fernandomcrsilva/Sistemas-Digitais/Ap1 parte2/docs/AP1_desenho_protoboard_2bits.pdf

AP1 · | Conferência de carga: montagem nas protoboards
Arduino Mega 2560 + 2 protoboards de 830 pontos · | versão de 2 bits por potenciômetro (X1 X0 em D23 D22, B1 B0 em D33 D32) · | 4 CIs · | conferida ligação por ligação (34 redes, 66 fios) · | CIs da esquerda

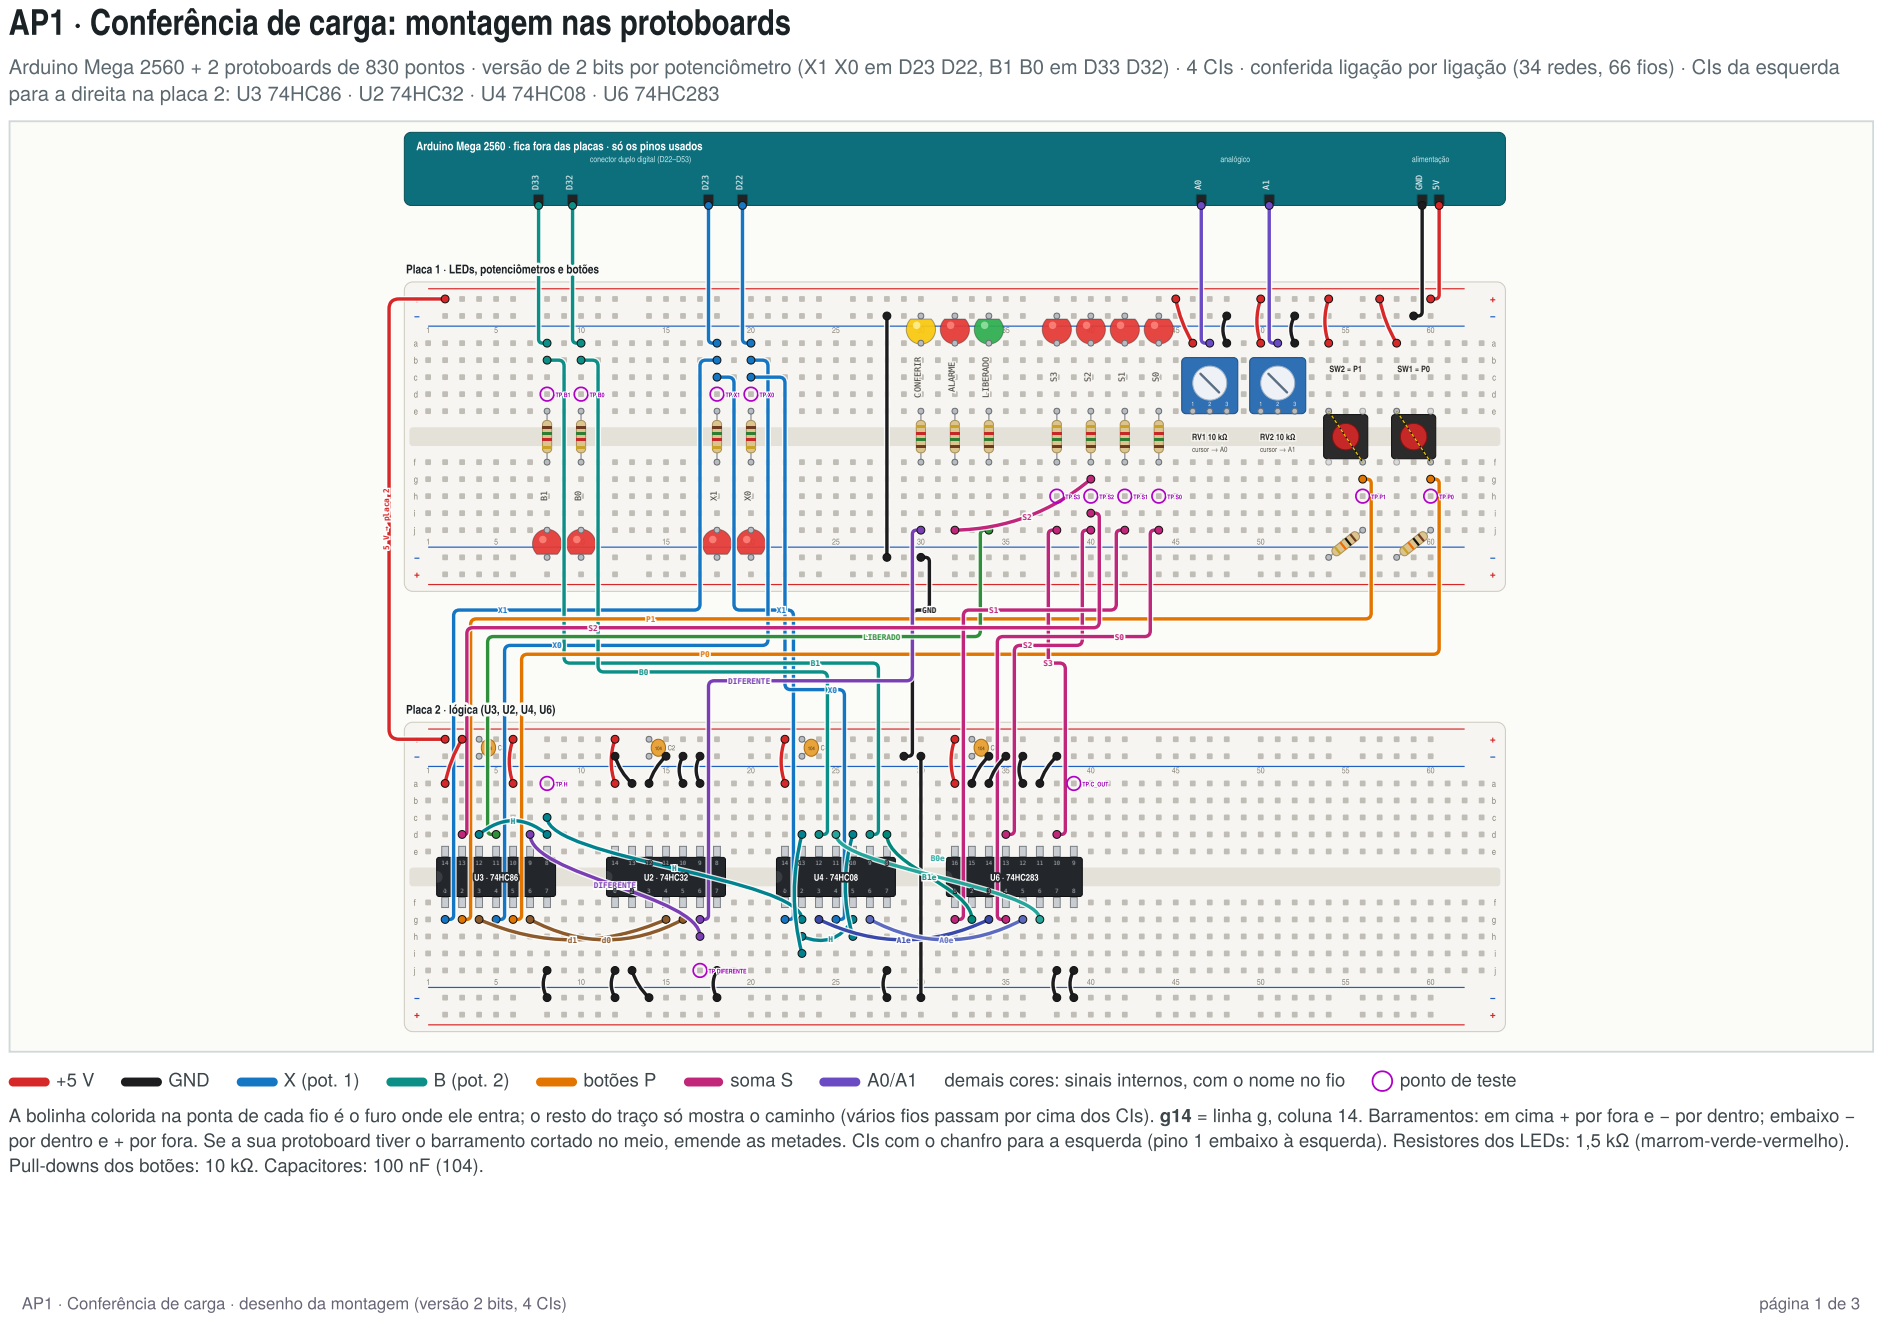
[picture p7: page 1]

Placa 1 · LEDs, potenciômetros e botões

A bolinha colorida na ponta de cada fio é o furo onde ele entra; o resto do traço só mostra o caminho (vários fios passam por cima dos CIs). g14 = linha g, coluna 14. Barramentos: em cima + por fora e − por dentro; embaixo −

por dentro e + por fora. Se a sua protoboard tiver o barramento cortado no meio, emende as metades. CIs com o chanfro para a esquerda (pino 1 embaixo à esquerda). Resistores dos LEDs: 1,5 kΩ (marrom-verde-vermelho).

Pull-downs dos botões: 10 kΩ. Capacitores: 100 nF (104).

Placa 1 · | LEDs, potenciômetros e botões (ampliada)
Arduino Mega 2560 · | fica fora das placas · | só os pinos usados

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
conector duplo digital (D22–D53) | analógico | alimentação
+ | +
− | −
− | −
+ | +
a | a
b | b
c | c
d | d
e | e
f | f
g | g
h | h
i | i
j | j

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
# CONFERIR CONFERIR

# ALARME ALARME

# LIBERADO LIBERADO

S3
S2

S1

S0

1 | 2 | 3

RV1 10 kΩ

## ccuurrssoorr →→ AA00

1 | 2 | 3

RV2 10 kΩ

## ccuurrssoorr →→ AA11

SW2 = P1 | SW1 = P0

5 V

→

## placa

## 2 5 V → placa 2

S22

TP B11 | TP B0 | TP XX11 | TP XX0
TP S3 | TP S2 | TP S11 | TP S0 | TP P11 | TP P0

# Placa 1 · LEDs, potenciômetros e botões

+5 V | GND | X (pot. 1) | B (pot. 2) | botões P | soma S | A0/A1 | demais cores: sinais internos, com o nome no fio | ponto de teste

A bolinha colorida na ponta de cada fio é o furo onde ele entra; o resto do traço só mostra o caminho (vários fios passam por cima dos CIs). g14 = linha g, coluna 14. Barramentos: em cima + por fora e − por dentro; embaixo −

por dentro e + por fora. Se a sua protoboard tiver o barramento cortado no meio, emende as metades. CIs com o chanfro para a esquerda (pino 1 embaixo à esquerda). Resistores dos LEDs: 1,5 kΩ (marrom-verde-vermelho).

Pull-downs dos botões: 10 kΩ. Capacitores: 100 nF (104).

AP1 · | Conferência de carga · | desenho da montagem (versão 2 bits, 4 CIs) | página 2 de 3

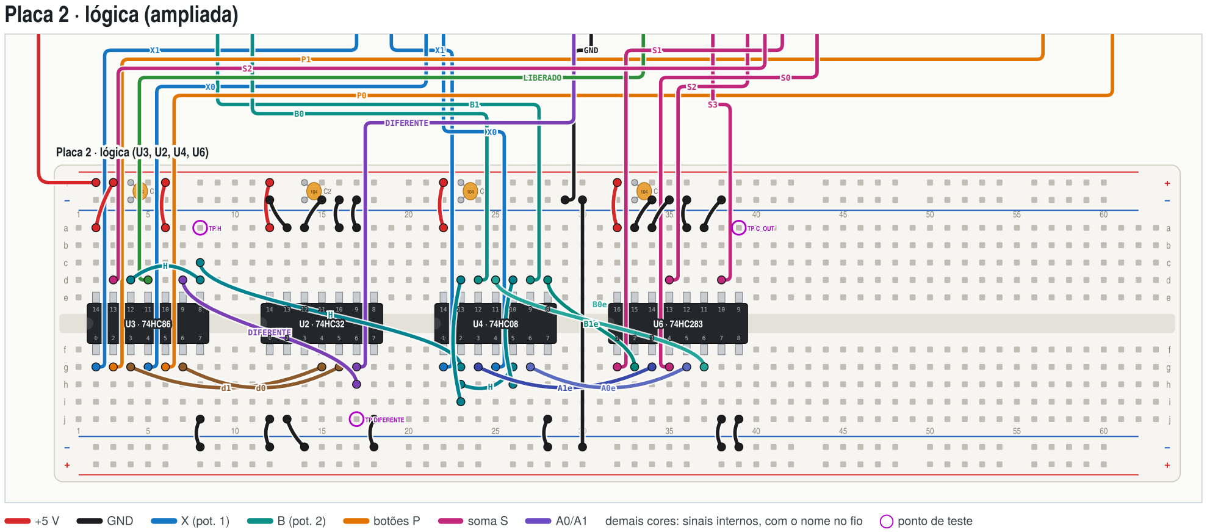
[picture p8: figure]
Placa 2 ·; lógica (ampliada); GND; DDIIFFEERREENNTTEE; LLIIBBEERRAADDOO; TTPP DDIIFFEERREENNTTEE; TTPP CC__OOUUTT; UU33 ·· 7744HHCC8866; UU22 ·· 7744HHCC3322; UU44 ·· 7744HHCC0088; UU66 ·· 7744HHCC228833

# Placa 2 · lógica (U3, U2, U4, U6)

+5 V | GND | X (pot. 1) | B (pot. 2) | botões P | soma S | A0/A1 | demais cores: sinais internos, com o nome no fio | ponto de teste

A bolinha colorida na ponta de cada fio é o furo onde ele entra; o resto do traço só mostra o caminho (vários fios passam por cima dos CIs). g14 = linha g, coluna 14. Barramentos: em cima + por fora e − por dentro; embaixo −

por dentro e + por fora. Se a sua protoboard tiver o barramento cortado no meio, emende as metades. CIs com o chanfro para a esquerda (pino 1 embaixo à esquerda). Resistores dos LEDs: 1,5 kΩ (marrom-verde-vermelho).

Pull-downs dos botões: 10 kΩ. Capacitores: 100 nF (104).

AP1 · | Conferência de carga · | desenho da montagem (versão 2 bits, 4 CIs) | página 3 de 3
