fernandomcrsilva/Sistemas-Digitais/Ap1 parte2/paginas/montagem-protoboard.html

AP1 · Sistemas Digitais 2026.2 · turma 6a

# Montagem da conferência de carga

Arduino Mega 2560 e duas protoboards de 830 pontos, na versão de 2 bits por potenciômetro: cada potenciômetro vira um valor de 0 a 3, o Mega acende X1 X0 (D23 D22) e B1 B0 (D33 D32), e a lógica usa 4 CIs (74HC86, 74HC32, 74HC08 e 74HC283). Cada ligação foi conferida por script contra o esquema.

34 de 34 redes iguais ao esquema · 66 fios

1 Alimentação2 Potenciômetros e botões3 Arduino → placa 14 Entre as placas5 Lógica na placa 2

Destacar − Ajustar +

+5 V GND X B botões P soma S A0/A1 demais cores: sinais internos, com o nome no fio ponto de teste clique num fio para destacar a rede

Destacando Limpar

Passo 1

### Alimentação

0/14

Mega nos barramentos, + e − entre as placas, VCC e GND de cada CI.

| # | Rede | De | | Para
| 1 | GND | Mega GND | → | 1·−59barramento − de cima
| 2 | VCC | Mega 5V | → | 1·+60barramento + de cima
| 3 | VCC | 1·+2barramento + de cima | → | 2·+2barramento + de cima
| 4 | GND | 1·−28barramento − de cima | → | 1·−28barramento − de baixo
| 5 | GND | 2·−30barramento − de cima | → | 2·−30barramento − de baixo
| 6 | GND | 1·−30barramento − de baixo | → | 2·−29barramento − de cima
| 7 | GND | 2·j8U3 pino 7 | → | 2·−8barramento − de baixo
| 8 | GND | 2·j18U2 pino 7 | → | 2·−18barramento − de baixo
| 9 | GND | 2·j28U4 pino 7 | → | 2·−28barramento − de baixo
| 10 | GND | 2·j39U6 pino 8 | → | 2·−39barramento − de baixo
| 11 | VCC | 2·a2U3 pino 14 | → | 2·+3barramento + de cima
| 12 | VCC | 2·a12U2 pino 14 | → | 2·+12barramento + de cima
| 13 | VCC | 2·a22U4 pino 14 | → | 2·+22barramento + de cima
| 14 | VCC | 2·a32U6 pino 16 | → | 2·+32barramento + de cima

Passo 2

### Potenciômetros e botões

0/6

Ligações curtas da placa 1 ao + e ao −.

| # | Rede | De | | Para
| 15 | GND | 1·a48RV1 pino 3 | → | 1·−48barramento − de cima
| 16 | GND | 1·a52RV2 pino 3 | → | 1·−52barramento − de cima
| 17 | VCC | 1·a46RV1 pino 1 | → | 1·+45barramento + de cima
| 18 | VCC | 1·a50RV2 pino 1 | → | 1·+50barramento + de cima
| 19 | VCC | 1·a54SW2 pino 1 | → | 1·+54barramento + de cima
| 20 | VCC | 1·a58SW1 pino 1 | → | 1·+57barramento + de cima

Passo 3

### Arduino → placa 1

0/6

Um fio por pino do Mega: D22–D25, D32–D35, A0, A1.

| # | Rede | De | | Para
| 21 | A0 | Mega A0 | → | 1·a47RV1 pino 2
| 22 | A1 | Mega A1 | → | 1·a51RV2 pino 2
| 23 | B0 | Mega D32 | → | 1·a10R11 · coluna do LED B0
| 24 | B1 | Mega D33 | → | 1·a8R12 · coluna do LED B1
| 25 | X0 | Mega D22 | → | 1·a20R1 · coluna do LED X0
| 26 | X1 | Mega D23 | → | 1·a18R2 · coluna do LED X1

Passo 4

### Entre as placas

0/16

Entradas da lógica e saídas para os LEDs.

| # | Rede | De | | Para
| 27 | B0 | 1·b10R11 · coluna do LED B0 | → | 2·d24U4 pino 12
| 28 | B1 | 1·b8R12 · coluna do LED B1 | → | 2·d27U4 pino 9
| 29 | DIFERENTE | 2·g17U2 pino 6 | → | 1·j30R17 · coluna do LED CONFERIR
| 30 | LIBERADO | 2·d5U3 pino 11 | → | 1·j34R19 · coluna do LED LIBERADO
| 31 | P0 | 1·g60SW1 pino 3 | → | 2·g6U3 pino 5
| 32 | P1 | 1·g56SW2 pino 3 | → | 2·g3U3 pino 2
| 33 | S0 | 2·g35U6 pino 4 | → | 1·j44R13 · coluna do LED S0
| 34 | S1 | 2·g32U6 pino 1 | → | 1·j42R14 · coluna do LED S1
| 35 | S2 | 2·d35U6 pino 13 | → | 1·j40R15 · coluna do LED S2
| 36 | S2 | 1·i40R15 · coluna do LED S2 | → | 2·d3U3 pino 13
| 37 | S3 | 2·d38U6 pino 10 | → | 1·j38R16 · coluna do LED S3
| 38 | X0 | 1·b20R1 · coluna do LED X0 | → | 2·g5U3 pino 4
| 39 | X0 | 1·c20R1 · coluna do LED X0 | → | 2·g25U4 pino 4
| 40 | X1 | 1·b18R2 · coluna do LED X1 | → | 2·g2U3 pino 1
| 41 | X1 | 1·c18R2 · coluna do LED X1 | → | 2·g22U4 pino 1
| 42 | S2 | 1·g40R15 · coluna do LED S2 | → | 1·j32R18 · coluna do LED ALARME

Passo 5

### Lógica na placa 2

0/24

Ligações entre portas e entradas ociosas no GND.

| # | Rede | De | | Para
| 43 | A0e | 2·g27U4 pino 6 | → | 2·g36U6 pino 5
| 44 | A1e | 2·g24U4 pino 3 | → | 2·g34U6 pino 3
| 45 | B0e | 2·d25U4 pino 11 | → | 2·g37U6 pino 6
| 46 | B1e | 2·d28U4 pino 8 | → | 2·g33U6 pino 2
| 47 | DIFERENTE | 2·h17U2 pino 6 | → | 2·d7U3 pino 9
| 48 | H | 2·d8U3 pino 8 | → | 2·d4U3 pino 12
| 49 | H | 2·c8U3 pino 8 | → | 2·g23U4 pino 2
| 50 | H | 2·h23U4 pino 2 | → | 2·g26U4 pino 5
| 51 | H | 2·i23U4 pino 2 | → | 2·d23U4 pino 13
| 52 | H | 2·h26U4 pino 5 | → | 2·d26U4 pino 10
| 53 | d0 | 2·g7U3 pino 6 | → | 2·g16U2 pino 5
| 54 | d1 | 2·g4U3 pino 3 | → | 2·g15U2 pino 4
| 55 | GND entrada ociosa | 2·a13U2 pino 13 | → | 2·−12barramento − de cima
| 56 | GND entrada ociosa | 2·a14U2 pino 12 | → | 2·−15barramento − de cima
| 57 | GND entrada ociosa | 2·a16U2 pino 10 | → | 2·−16barramento − de cima
| 58 | GND entrada ociosa | 2·a17U2 pino 9 | → | 2·−17barramento − de cima
| 59 | GND entrada ociosa | 2·a33U6 pino 15 | → | 2·−34barramento − de cima
| 60 | GND entrada ociosa | 2·a34U6 pino 14 | → | 2·−35barramento − de cima
| 61 | GND entrada ociosa | 2·a36U6 pino 12 | → | 2·−36barramento − de cima
| 62 | GND entrada ociosa | 2·a37U6 pino 11 | → | 2·−38barramento − de cima
| 63 | GND entrada ociosa | 2·j12U2 pino 1 | → | 2·−12barramento − de baixo
| 64 | GND entrada ociosa | 2·j13U2 pino 2 | → | 2·−14barramento − de baixo
| 65 | GND entrada ociosa | 2·j38U6 pino 7 | → | 2·−38barramento − de baixo
| 66 | VCC entrada ociosa | 2·a6U3 pino 10 | → | 2·+6barramento + de cima

Onde vai cada componente

Ref. | Peça | Posição
U3 | 74HC86 | Placa 2, colunas 2–8, atravessando o canal. Pino 1 em f2, chanfro para a esquerda.
U2 | 74HC32 | Placa 2, colunas 12–18, atravessando o canal. Pino 1 em f12, chanfro para a esquerda.
U4 | 74HC08 | Placa 2, colunas 22–28, atravessando o canal. Pino 1 em f22, chanfro para a esquerda.
U6 | 74HC283 | Placa 2, colunas 32–39, atravessando o canal. Pino 1 em f32, chanfro para a esquerda.
C3 | 100 nF (104) | Placa 2, entre os barramentos + e − de cima, coluna 4.
C2 | 100 nF (104) | Placa 2, entre os barramentos + e − de cima, coluna 14.
C4 | 100 nF (104) | Placa 2, entre os barramentos + e − de cima, coluna 23.
C6 | 100 nF (104) | Placa 2, entre os barramentos + e − de cima, coluna 33.
R12 + D12 | 1,5 kΩ + LED vermelho (B1) | Placa 1: R12 de e8 a f8; LED com a perna longa em j8 e o lado chato no − de baixo.
R11 + D11 | 1,5 kΩ + LED vermelho (B0) | Placa 1: R11 de e10 a f10; LED com a perna longa em j10 e o lado chato no − de baixo.
R2 + D2 | 1,5 kΩ + LED vermelho (X1) | Placa 1: R2 de e18 a f18; LED com a perna longa em j18 e o lado chato no − de baixo.
R1 + D1 | 1,5 kΩ + LED vermelho (X0) | Placa 1: R1 de e20 a f20; LED com a perna longa em j20 e o lado chato no − de baixo.
R17 + D17 | 1,5 kΩ + LED amarelo (CONFERIR) | Placa 1: R17 de f30 a e30; LED com a perna longa em a30 e o lado chato no − de cima.
R18 + D18 | 1,5 kΩ + LED vermelho (ALARME) | Placa 1: R18 de f32 a e32; LED com a perna longa em a32 e o lado chato no − de cima.
R19 + D19 | 1,5 kΩ + LED verde (LIBERADO) | Placa 1: R19 de f34 a e34; LED com a perna longa em a34 e o lado chato no − de cima.
R16 + D16 | 1,5 kΩ + LED vermelho (S3) | Placa 1: R16 de f38 a e38; LED com a perna longa em a38 e o lado chato no − de cima.
R15 + D15 | 1,5 kΩ + LED vermelho (S2) | Placa 1: R15 de f40 a e40; LED com a perna longa em a40 e o lado chato no − de cima.
R14 + D14 | 1,5 kΩ + LED vermelho (S1) | Placa 1: R14 de f42 a e42; LED com a perna longa em a42 e o lado chato no − de cima.
R13 + D13 | 1,5 kΩ + LED vermelho (S0) | Placa 1: R13 de f44 a e44; LED com a perna longa em a44 e o lado chato no − de cima.
RV1 | trimpot 10 kΩ | Placa 1: pino 1 em e46, cursor em e47, pino 3 em e48.
RV2 | trimpot 10 kΩ | Placa 1: pino 1 em e50, cursor em e51, pino 3 em e52.
SW2 | botão 6×6 (P1) | Placa 1, atravessando o canal: pernas em e54, e56, f54, f56. Usa a diagonal e54 (+5 V) e f56 (P1).
SW1 | botão 6×6 (P0) | Placa 1, atravessando o canal: pernas em e58, e60, f58, f60. Usa a diagonal e58 (+5 V) e f60 (P0).
Rpd2 | 10 kΩ pull-down (P1) | Placa 1: de j56 ao barr. − de baixo, col 54.
Rpd1 | 10 kΩ pull-down (P0) | Placa 1: de j60 ao barr. − de baixo, col 58.

## Versão 2 bits: a lógica

1. Cada potenciômetro dá 2 bits: 0–25% = 00, 25–50% = 01, 50–75% = 10, acima de 75% = 11. Com isso a FALHA (X ≥ 4) não existe mais.
2. d1 = X1 ⊕ P1 e d0 = X0 ⊕ P0 (U3 1,2→3 e 4,5→6); DIFERENTE = d1 + d0 (U2 4,5→6) acende o LED CONFERIR.
3. H = DIFERENTE ⊕ 1 (U3 9,10→8, pino 10 no +5 V). As 4 portas AND do U4 deixam X e B chegarem ao somador só com H = 1.
4. ALARME = S2 (soma ≥ 4) e LIBERADO = H ⊕ S2 (U3 12,13→11).
5. U2 usa só a porta 2; as entradas das outras portas vão ao GND. O LED S3 nunca acende (a soma vai até 6).

## Como ler os furos

2·g14 = placa 2, linha g, coluna 14. 1·+60 = placa 1, barramento +, coluna 60. Em cada coluna, a–e formam um nó e f–j formam outro; o canal do meio separa os dois.

Qualquer furo livre do mesmo nó serve. O desenho escolhe um para não amontoar fios.

## Antes de ligar

1. Barramentos: em cima o + fica por fora e o − por dentro; embaixo o − fica por dentro. Se a sua placa tiver o barramento cortado no meio (perto da coluna 30), emende as duas metades com um fio.
2. CIs: chanfro para a esquerda, pino 1 embaixo à esquerda (linha f). O VCC é o pino 14 (16 no 74HC283) e o GND é o 7 (8 no 74HC283).
3. Capacitores 104: um por CI, direto entre o + e o − de cima, ao lado do fio de VCC daquele CI.
4. LEDs: perna longa (ânodo) no furo marcado; lado chato (cátodo) no barramento −. Cada LED tem o seu 1,5 kΩ atravessando o canal.
5. Botões: use os terminais da diagonal amarela. Solto, o pull-down de 10 kΩ deixa o sinal em 0.
6. Entradas ociosas dos CIs vão ao GND (fios pretos curtos no passo 5). Saídas que não são usadas ficam soltas.
7. Monte e teste um passo por vez. Depois do passo 1, meça 5 V entre + e − nas duas placas antes de colocar os CIs.
