fernandomcrsilva/Sistemas-Digitais/Ap1 parte2/docs/AP1_bateria_de_testes_2bits.pdf

AP1 · | Conferência de carga: bateria de testes
Versão de 2 bits por potenciômetro, 4 CIs · | resultados esperados calculados porta a porta a partir do esquema (34 redes) · | sketch
conferencia_carga_2bits.ino

Monitor Serial em 9600 baud, final de linha Nova linha. Cada TESTE N0 N1 fixa o par (0 a 1023); ANALOGICO volta aos

potenciômetros.

Cada valor vira 2 bits: 0–255 = 00, 256–511 = 01, 512–767 = 10, 768–1023 = 11. Os comandos usam 128, 384, 640 e 896 (meio de cada faixa). O Mega acende X1 X0 (D23 D22) e B1 B0 (D33 D32).

Botões: SW2 = P1 (bit alto de R) e SW1 = P0 (bit baixo). Em S3–S0, 1 = LED aceso.

Em qualquer situação, exatamente um entre CONFERIR, ALARME e LIBERADO fica aceso.

Se um teste falhar, anote o número e continue; o bloco que falhou indica onde procurar (1: Arduino e fios do Mega · 2: U3/U2 · 3: U4/U6 e U3 pinos 12, 13 → 11).

### 1 · Aquisição (Arduino, sem a lógica)

Comece em modo ANALOGICO e gire os potenciômetros. Depois use os comandos TESTE. Os LEDs X1 X0 e B1 B0 têm que mostrar os mesmos bits que aparecem depois de -> no serial (no monitor é uma linha só; ele imprime a cada 0,5 s).

POTENCIÔMETRO POSIÇÃO | ESPERADO | OBTIDO | OK
RV1 (pot. 1) | mínimo | POT1 perto de 0 (0%) · 00 · X1 e X0 apagados | | ☐
RV1 (pot. 1) | girando devagar até o máximo | passa por 01, 10 e 11; troca perto de 28%, 53% e 78% (subindo) | | ☐
RV1 (pot. 1) | voltando devagar | troca perto de 72%, 47% e 22% (descendo): é a histerese | | ☐
RV1 (pot. 1) | parado bem em cima de 25% | X1 X0 não ficam piscando | | ☐
RV2 (pot. 2) | girando de ponta a ponta | B1 B0 passam por 00, 01, 10 e 11, igual ao RV1 | | ☐
COMANDO | O SERIAL IMPRIME | LEDS DE ENTRADA ACESOS | OBTIDO | OK

TESTE 0 0

[TESTE] | POT1: 0 (0%) -> 00 (0)
| | POT2: 0 (0%) -> 00 (0) | nenhum | | ☐

TESTE 255 256

[TESTE] | POT1: 255 (24%) -> 00 (0)
| | POT2: 256 (25%) -> 01 (1) | B0
| | fronteira de 25%: 255 ainda é 00, 256 já é 01 | | ☐

TESTE 511 512

[TESTE] | POT1: 511 (49%) -> 01 (1)
| | POT2: 512 (50%) -> 10 (2) | X0, B1
| | fronteira de 50% | | ☐

TESTE 767 768

[TESTE] | POT1: 767 (74%) -> 10 (2)
| | POT2: 768 (75%) -> 11 (3) | X1, B1, B0
| | fronteira de 75% | | ☐

TESTE 1023 1023

[TESTE] | POT1: 1023 (100%) -> 11 (3)
| | POT2: 1023 (100%) -> 11 (3) | os 4 | | ☐

TESTE 640 128

[TESTE] | POT1: 640 (62%) -> 10 (2)
| | POT2: 128 (12%) -> 00 (0) | X1 | | ☐

TESTE 128 896

[TESTE] | POT1: 128 (12%) -> 00 (0)
| | POT2: 896 (87%) -> 11 (3) | B1, B0 | | ☐
COMANDO INVÁLIDO | RESPOSTA ESPERADA (PAR ANTERIOR MANTIDO) | OBTIDO | OK
TESTE 2000 1 | Comando invalido - par vigente mantido | | ☐
TESTE 5 | Comando invalido - par vigente mantido | | ☐
abc | Comando invalido - par vigente mantido | | ☐
2 · | Comparador: os 16 pares A × R (pot. 2 em 00)

R = botões (SW2 = P1, SW1 = P0). DIFERENTE pode ser medido no TP DIFERENTE (U2 pino 6) e é o próprio LED CONFERIR; H é o contrário dele (TP H = U3 pino 8).

AP1 · | Conferência de carga · | bateria de testes (versão 2 bits, 4 CIs) | página 1 de 3

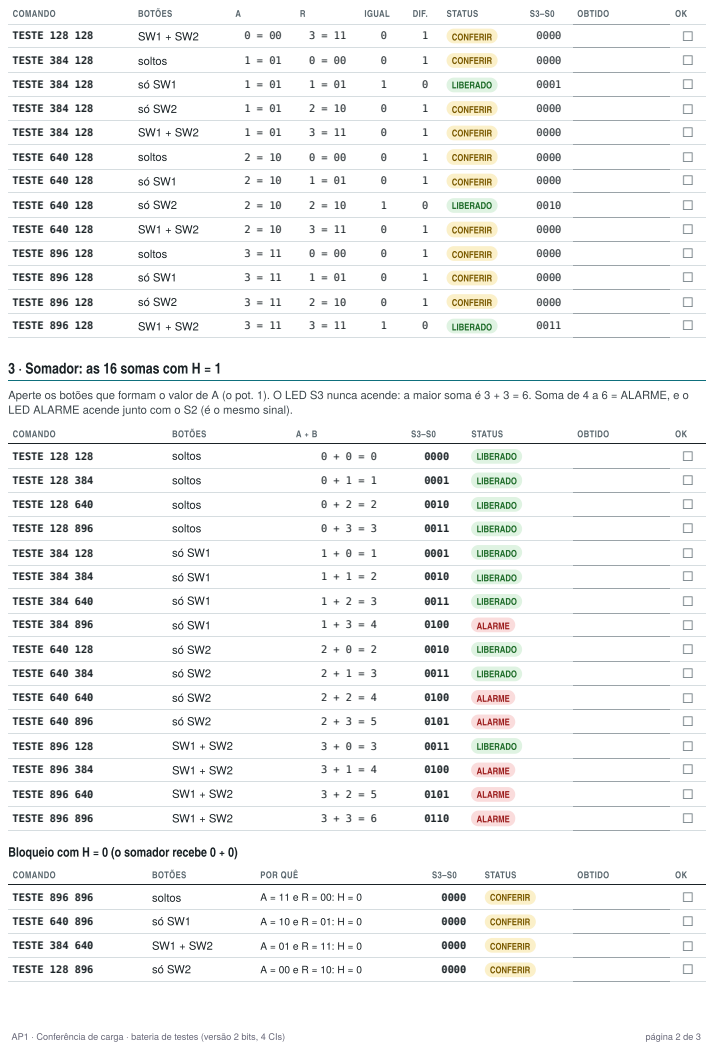
[picture p23: page 2]
COMANDO; BOTÕES; IGUAL; DIF.; STATUS; OBTIDO; TESTE 128 128; CONFERIR; TESTE 384 128; soltos; LIBERADO; TESTE 640 128; TESTE 896 128; Somador: as 16 somas com H = 1; TESTE 128 384; TESTE 128 640; TESTE 128 896; TESTE 384 384; TESTE 384 640; TESTE 384 896; ALARME; TESTE 640 384; TESTE 640 640; TESTE 640 896; TESTE 896 384; TESTE 896 640; TESTE 896 896; POR QUÊ; Conferência de carga ·; bateria de testes (versão 2 bits, 4 CIs); página 2 de 3

Aperte os botões que formam o valor de A (o pot. 1). O LED S3 nunca acende: a maior soma é 3 + 3 = 6. Soma de 4 a 6 = ALARME, e o
LED ALARME acende junto com o S2 (é o mesmo sinal).

Bloqueio com H = 0 (o somador recebe 0 + 0)

### 4 · Integração

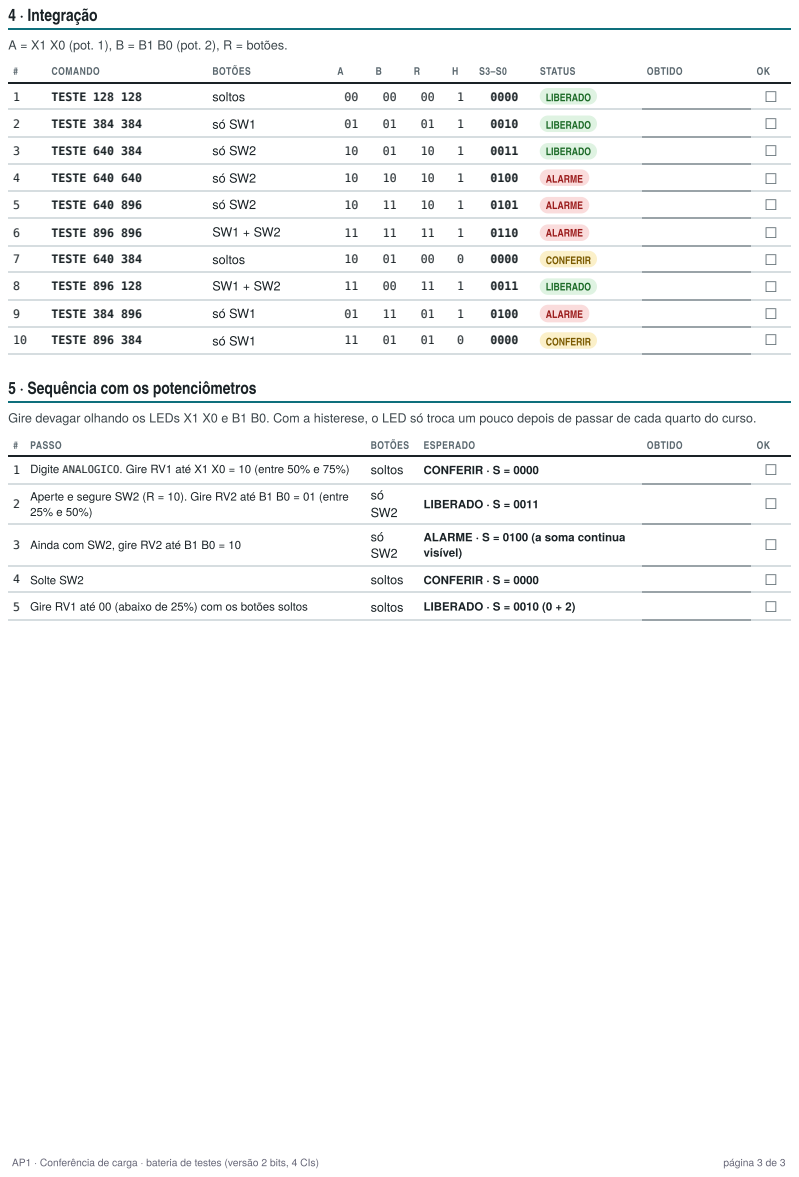
[picture p24: page 3]
COMANDO; BOTÕES; STATUS; OBTIDO; TESTE 128 128; soltos; LIBERADO; TESTE 384 384; TESTE 640 384; TESTE 640 640; ALARME; TESTE 640 896; TESTE 896 896; CONFERIR; TESTE 896 128; TESTE 384 896; TESTE 896 384; Sequência com os potenciômetros; # PASSO; BOTÕES ESPERADO; 1 Digite ANALOGICO. Gire RV1 até X1 X0 = 10 (entre 50% e 75%); CONFERIR ·; LIBERADO ·; ALARME ·; S = 0100 (a soma continua; visível); 4 Solte SW2; 5 Gire RV1 até 00 (abaixo de 25%) com os botões soltos; Conferência de carga ·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

A = X1 X0 (pot. 1), B = B1 B0 (pot. 2), R = botões.

Gire devagar olhando os LEDs X1 X0 e B1 B0. Com a histerese, o LED só troca um pouco depois de passar de cada quarto do curso.

Aperte e segure SW2 (R = 10). Gire RV2 até B1 B0 = 01 (entre

3 Ainda com SW2, gire RV2 até B1 B0 = 10
