fernandomcrsilva/Sistemas-Digitais/esquema/a5824a00-221a-4c01-ba58-66c36497fe74.pdf

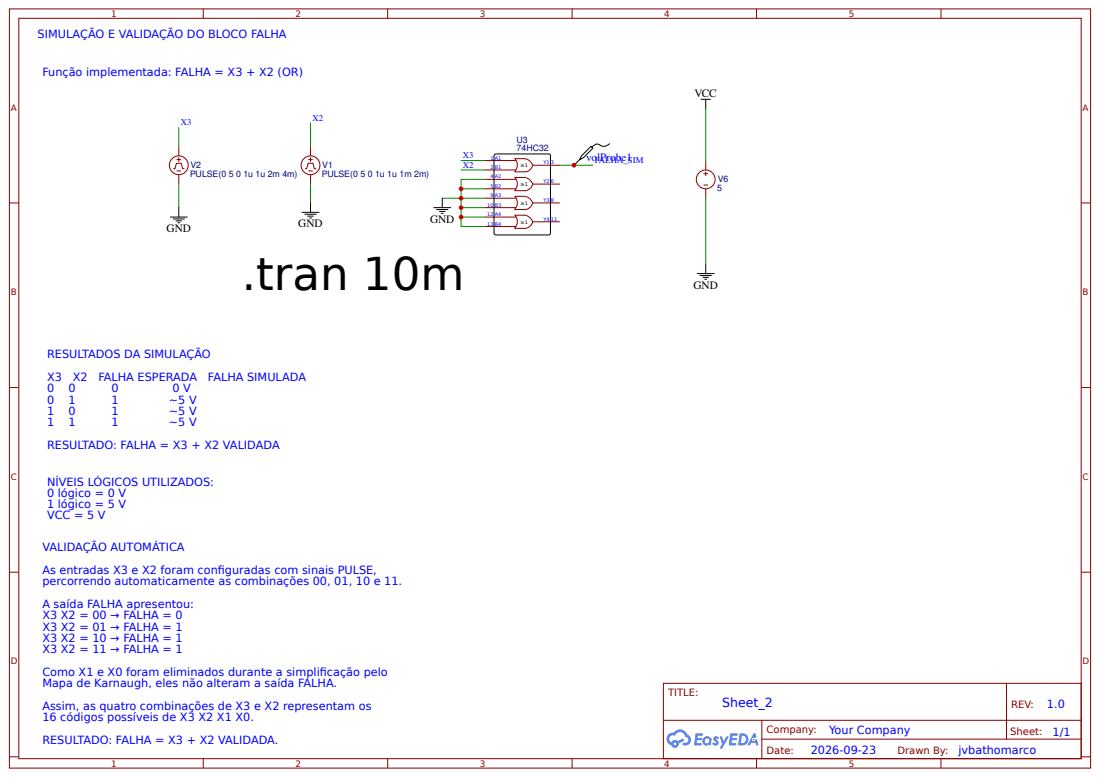
[picture p25: page 1]
TITLE:; Sheet_2; REV: 1.0; Date:; Sheet: 1/1; GND; FALHA_SIM; .tran 10m; volProbe1; VCC; PULSE(0 5 0 1u 1u 1m 2m); PULSE(0 5 0 1u 1u 2m 4m)

SIMULAÇÃO E VALIDAÇÃO DO BLOCO FALHA

Função implementada: FALHA = X3 + X2 (OR)

RESULTADOS DA SIMULAÇÃO
X3 X2 FALHA ESPERADA FALHA SIMULADA
RESULTADO: FALHA = X3 + X2 VALIDADA

NÍVEIS LÓGICOS UTILIZADOS:
0 lógico = 0 V
1 lógico = 5 V
VCC = 5 V

VALIDAÇÃO AUTOMÁTICA
As entradas X3 e X2 foram configuradas com sinais PULSE,
percorrendo automaticamente as combinações 00, 01, 10 e 11.
A saída FALHA apresentou:
X3 X2 = 00 → FALHA = 0
X3 X2 = 01 → FALHA = 1
X3 X2 = 10 → FALHA = 1
X3 X2 = 11 → FALHA = 1
Como X1 e X0 foram eliminados durante a simplificação pelo
Mapa de Karnaugh, eles não alteram a saída FALHA.
Assim, as quatro combinações de X3 e X2 representam os
16 códigos possíveis de X3 X2 X1 X0.
RESULTADO: FALHA = X3 + X2 VALIDADA.

Company: Your Company

Drawn By: jvbathomarco
