fernandomcrsilva/Sistemas-Digitais/esquema/a7d29431-72c8-48da-b32c-ddb8ccf4125f.pdf

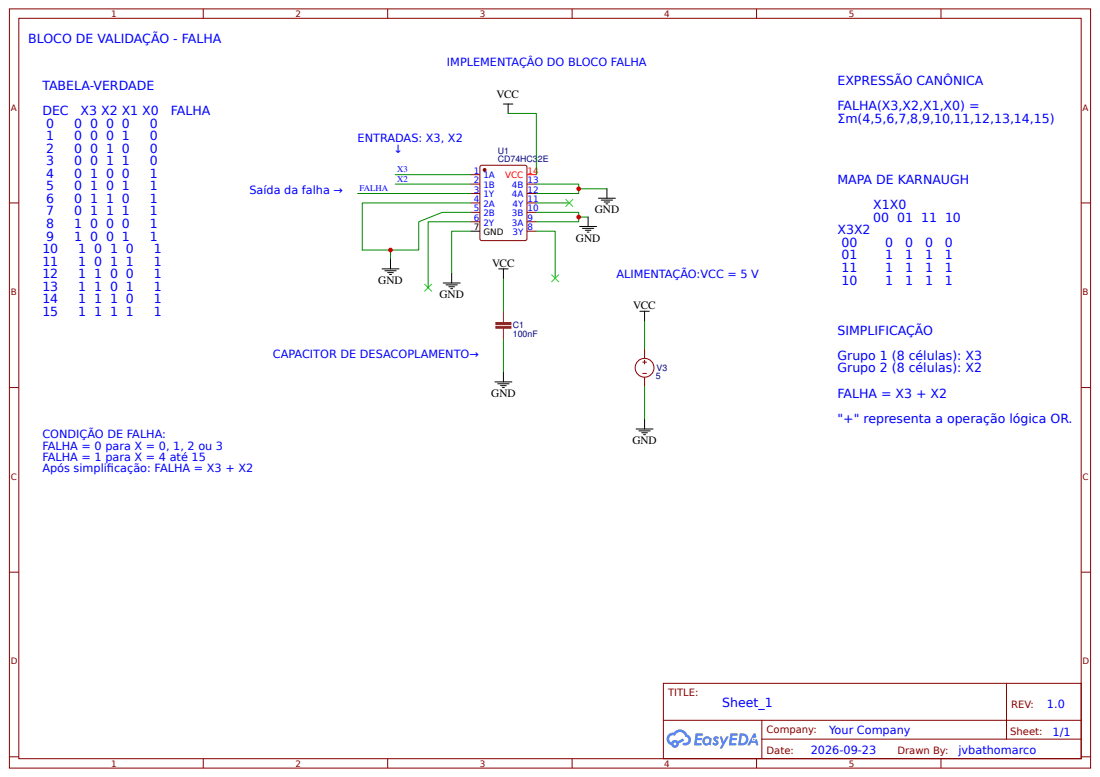
[picture p26: page 1]
TITLE:; Sheet_1; REV: 1.0; Date:; Sheet: 1/1; TABELA-VERDADE; DEC X3 X2 X1 X0 FALHA; EXPRESSÃO CANÔNICA; FALHA(X3,X2,X1,X0) = Σm(4,5,6,7,8,9,10,11,12,13,14,15); MAPA DE KARNAUGH; GND 7; 3Y 8 3A 9 3B 10 4Y 11 4A 12 4B 13 VCC X3; FALHA; GND; VCC; ALIMENTAÇÃO:VCC = 5 V; ENTRADAS: X3, X2 ↓

BLOCO DE VALIDAÇÃO - FALHA

IMPLEMENTAÇÂO DO BLOCO FALHA

Saída da falha →

SIMPLIFICAÇÃO
Grupo 1 (8 células): X3
Grupo 2 (8 células): X2
FALHA = X3 + X2
"+" representa a operação lógica OR.

CAPACITOR DE DESACOPLAMENTO→

CONDIÇÃO DE FALHA:
FALHA = 0 para X = 0, 1, 2 ou 3
FALHA = 1 para X = 4 até 15
Após simplificação: FALHA = X3 + X2

Company: Your Company

Drawn By: jvbathomarco
