fernandomcrsilva/Sistemas-Digitais/esquema/AP1_desenho_protoboard.pdf

AP1 · | Conferência de carga: montagem nas protoboards
Arduino Mega 2560 + 2 protoboards de 830 pontos · | desenho conferido ligação por ligação com a folha 1 do esquema (57 redes, 92 fios) · | CIs da esquerda para a direita na placa 2: U3 74HC86 · | U2 74HC32 ·
U1 74HC04 · | U5 74HC08 · | U4 74HC08 · | U6 74HC283
Arduino Mega 2560 · | fica fora das placas · | só os pinos usados

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
conector duplo digital (D22–D53) | analógico | alimentação
+ | +
− | −
− | −
+ | +
a | a
b | b
c | c
d | d
e | e
f | f
g | g
h | h
i | i
j | j

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
N0_9_

N0_8_
N0_7_

N0_6_
N0_5_

N0_4_
X3
X2

X1

X0
B1

B0

CONFERIR CONFERIR

### ALARME ALARME

### LIBERADO LIBERADO

S3
S2

S1

S0

1 | 2 | 3

RV1 10 kΩ
ccuurrssoorr →→ AA00
1 | 2 | 3

RV2 10 kΩ
ccuurrssoorr →→ AA11
SW2 = P1 | SW1 = P0
104 | C3 | 104 | C2 | 104 | C1 | 104 | C5 | 104 | C4 | 104 | C6

GND

XX3
XX22
XX1 | XX1
XX0

XX0

B1

B0

P1
P0

CCOONNFFEERRIIRR

ALARME | LIBERADO

S3

S22
S1

S0

S3
S22

5 V → placa 2 5 V → placa 2

d1 | d0 | FALHA DDIIFFEERREENNTTEE

DDIIFFEERREENNTTEE

EEXXCCEESSSSOO

EEXXCCEESSSSOO

nnFFAALLHHAA

nnFFAALLHHAA

IGUAL

nnEEXXCCEESSSSOO | H

H

H

A1e | A0e B1e B0e
TP XX3 | TP XX2 | TP XX11 | TP XX0 | TP B11 | TP B0
TP S3 | TP S2 | TP S11 | TP S0 | TP P11 | TP P0

TP FALHA

TP DIFERENTE

TP IGUAL

TP H

TP C_OUT

## Placa 1 · LEDs, potenciômetros e botões

## Placa 2 · lógica (U3, U2, U1, U5, U4, U6)

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
UU33 ·· 7744HHCC8866
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
UU22 ·· 7744HHCC3322
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
UU11 ·· 7744HHCC0044
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
UU55 ·· 7744HHCC0088
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
UU44 ·· 7744HHCC0088
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
UU66 ·· 7744HHCC228833
+5 V | GND | N0 (só LED) | X | B | botões P | soma S | A0/A1 | demais cores: sinais internos, com o nome no fio | ponto de teste

A bolinha colorida na ponta de cada fio é o furo onde ele entra; o resto do traço só mostra o caminho (vários fios passam por cima dos CIs). g14 = linha g, coluna 14. Barramentos: em cima + por fora e − por dentro; embaixo −

por dentro e + por fora. Se a sua protoboard tiver o barramento cortado no meio, emende as metades. CIs com o chanfro para a esquerda (pino 1 embaixo à esquerda). Resistores dos LEDs: 1,5 kΩ (marrom-verde-vermelho).

Pull-downs dos botões: 10 kΩ. Capacitores: 100 nF (104).

AP1 · | Conferência de carga · | desenho da montagem nas protoboards | página 1 de 3

Placa 1 · | LEDs, potenciômetros e botões (ampliada)
Arduino Mega 2560 · | fica fora das placas · | só os pinos usados

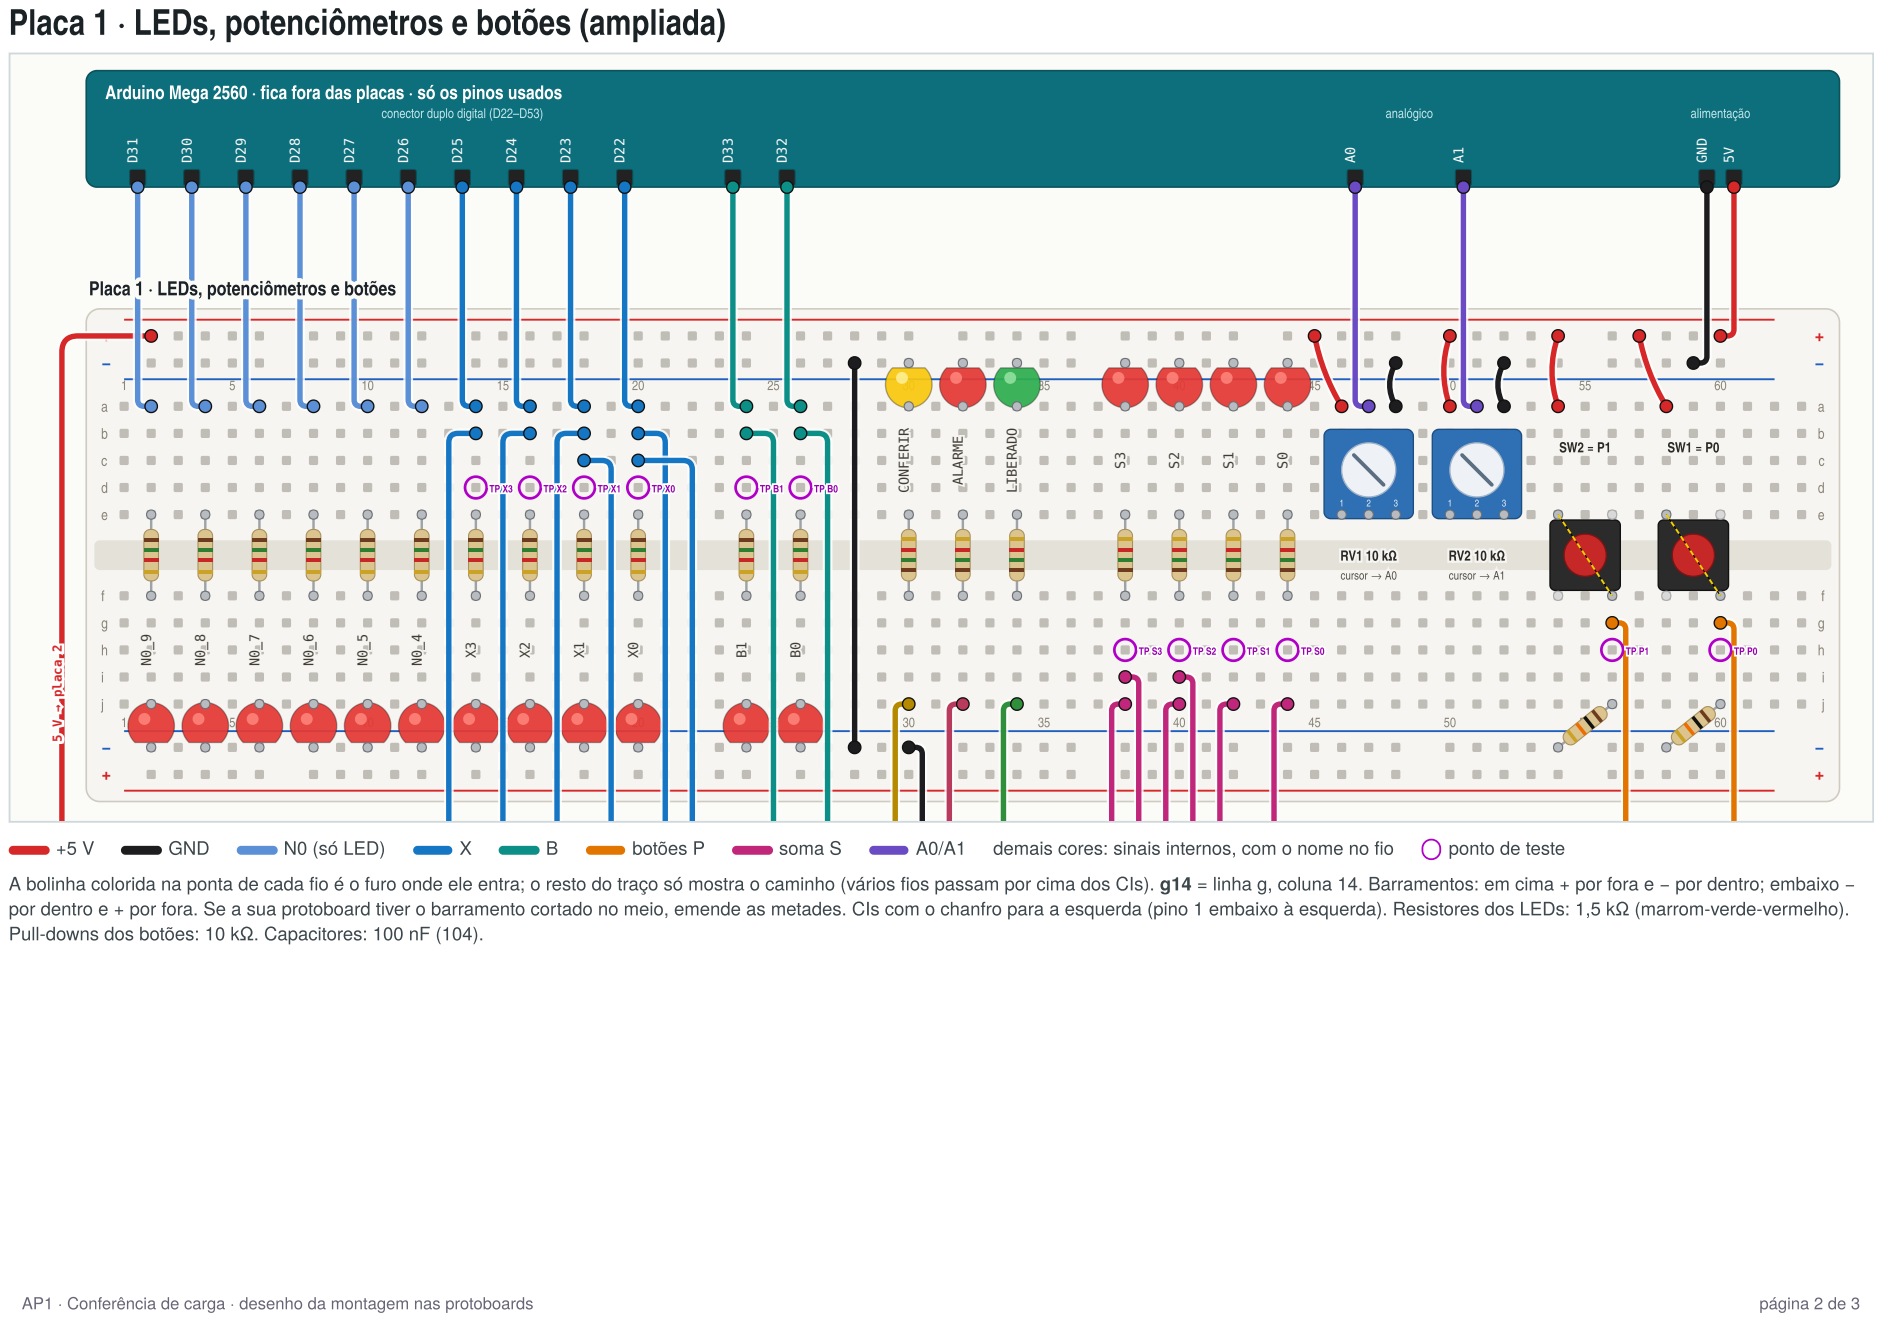
[picture p27: page 2]

Placa 1 · LEDs, potenciômetros e botões

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

Pull-downs dos botões: 10 kΩ. Capacitores: 100 nF (104).

# Placa 2 · lógica (ampliada)

## GND

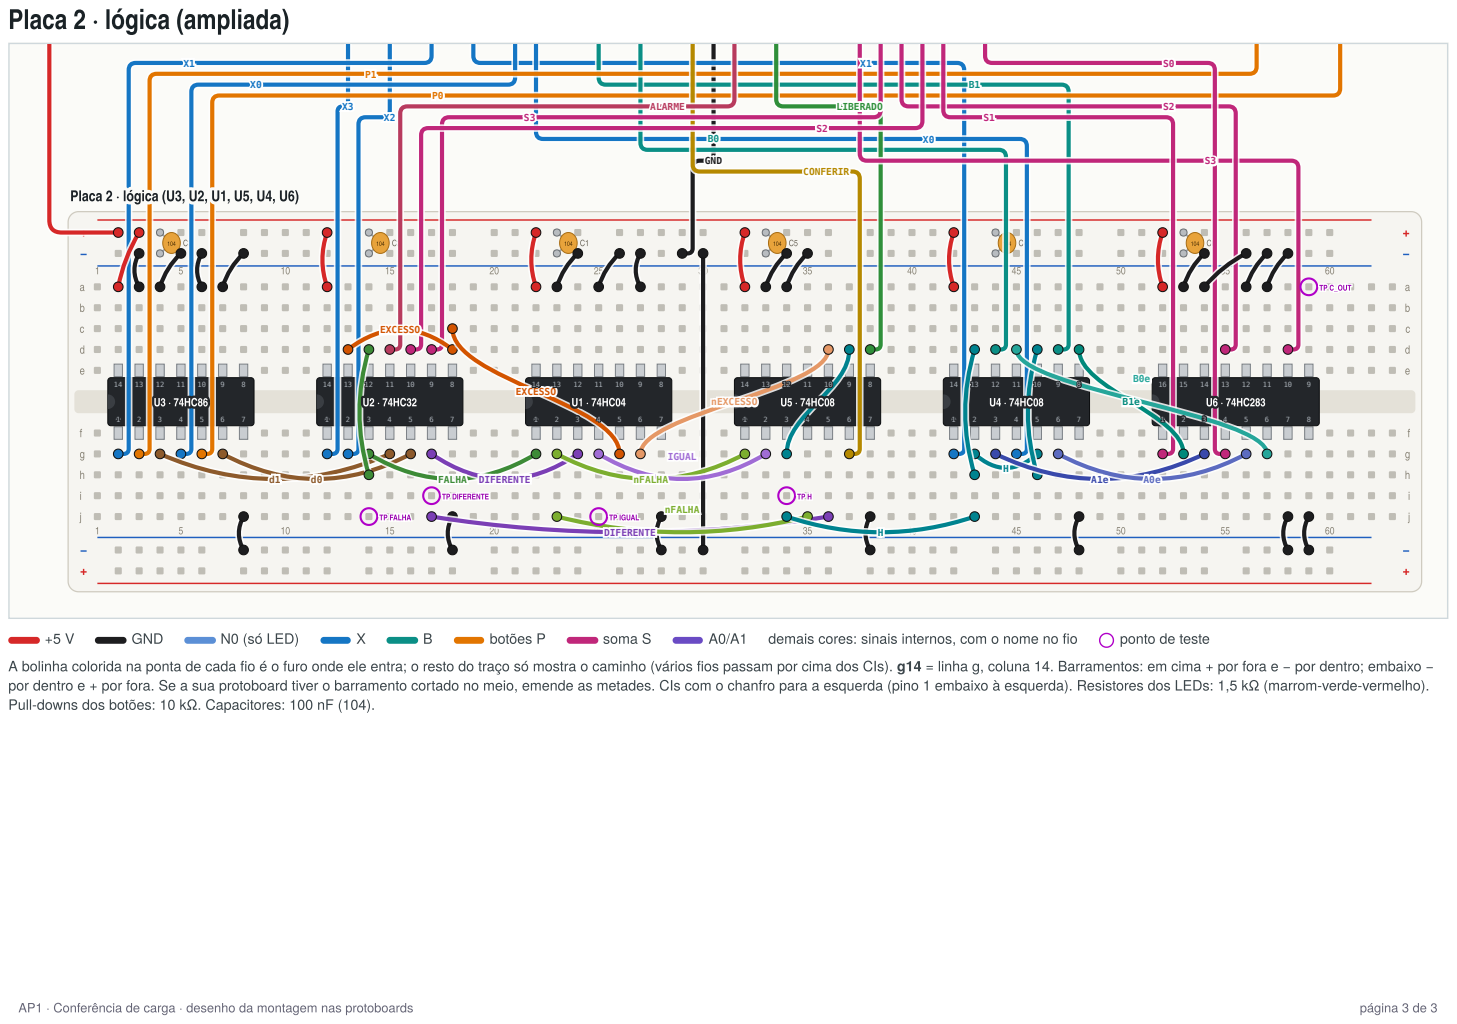
[picture p28: page 3]
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

Pull-downs dos botões: 10 kΩ. Capacitores: 100 nF (104).
