fernandomcrsilva/Sistemas-Digitais/Ap1 parte2/esquema/esquema_logico_2bits.pdf

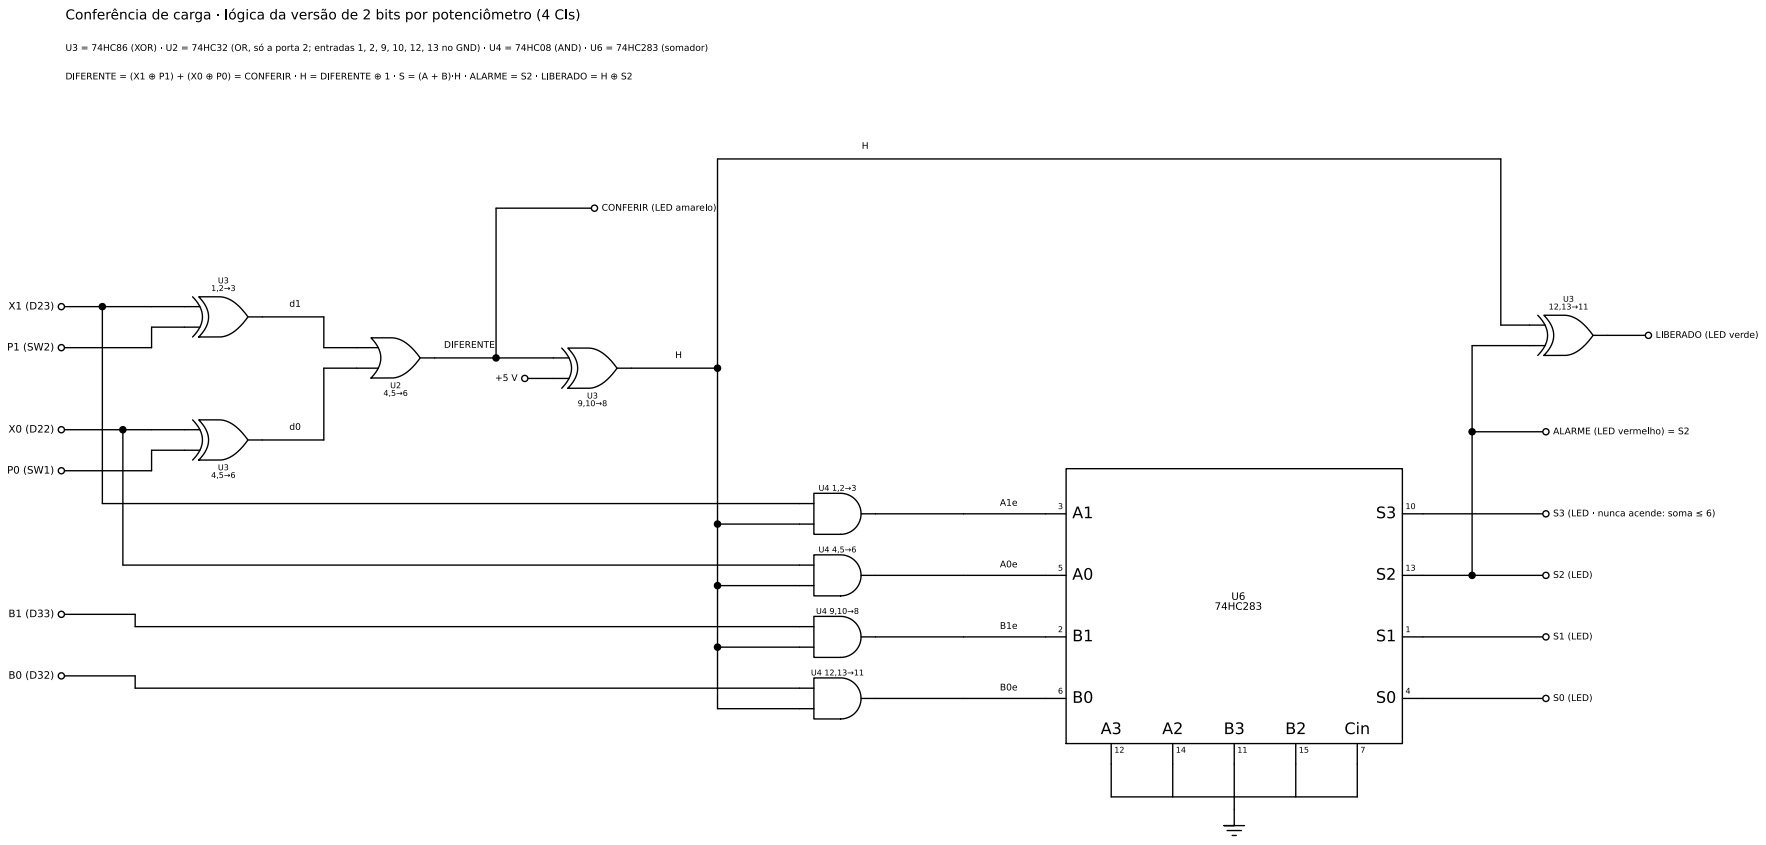
[picture p36: page 1]
