fernandomcrsilva/Sistemas-Digitais/(list of files, drawings)

Other design files:
esquema/SCH_AP1_Sistema-Digitais_2026-10-01.json
