fernandomcrsilva/Sistemas-Digitais/(commit log)

2026-09-16 Esquema EasyEDA com 4 folhas, PCB, protoboard, sketch e testes
    - folha 1: circuito com simbolos da biblioteca LCSC (biblioteca.py baixa
    da API e guarda em esquema/lib para gerar offline)
    - folha 2: notas de modelagem e registro de testes
    - folha 3: montagem no estilo dos exemplos do EasyEDA - Arduino da
    biblioteca de usuarios no centro e pecas da Commons Library em volta
    (extraidas do JS do editor), fora da BOM e da PCB
    - folha 4: montagem em protoboard (desenho + lista furo a furo)
    - PCB de 2 camadas roteada (gerar_pcb.py); tudo parte da netlist unica
    de gerar_netlist.py
    - sketch conferencia_carga.ino com teste de host; teste_netlist simula o
    circuito porta a porta e teste_esquema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
2026-09-16 Folha 3: circuito completo ligado fio a fio, com moldura e legenda
    - roteador de canal em gerar_esquema.py: uma trilha por net (left-edge),
    descidas ate cada pino com tocos de comprimentos distintos por lado,
    juncao so onde liga; sem rotulos de net; X0-X3 por cima dos CIs, o
    resto por baixo; entradas ociosas ao GND por trilhas curtas
    - moldura com zonas 1-8 / A-E e bloco de titulo (TITLE, REV, Company,
    Sheet, Date, Drawn By), como as folhas de exemplo do EasyEDA
    - barramento lateral de GND (folhas 1 e 3): ponto de juncao em toda
    ponta que termina no meio do barramento - o EasyEDA so liga "T" com
    o ponto; tres entradas ociosas estavam soltas no editor
    - teste_esquema.py aplica a r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
2026-09-16 Revisao: lint geometrico no verificador e ajustes de bandeiras e textos
    - teste_esquema.py: alem da conectividade, acusa ponta de fio no meio de
    outro sem juncao, fios sobrepostos, fio atravessando simbolo, ponta
    solta e juncao fora de fio (validado contra o JSON antigo, que tinha
    as tres entradas ociosas soltas)
    - bandeiras de alimentacao em L, afastadas dos tocos vizinhos (folhas 1
    e 3); barramento das entradas ociosas sobe quando elas ficam acima
    dos sinais (U5), com a bandeira ao lado
    - texto de valor dos CIs deslocado para nao colidir com a bandeira VCC
    do 74HC283
2026-09-16 Folha 3: canal duplo de trilhas e CIs na ordem do fluxo do sinal
2026-09-16 Folha 3: sem a linha de nota sob o título
